cqeta1564/MotoLogger/README.md

# MotoLogger: Comprehensive Motorcycle Telemetry Ecosystem







An end-to-end, high-performance motorcycle telemetry and data acquisition system. Features a custom **ESP32-S3 hardware logger**, **100 Hz BNO085 IMU fusion** for vibration-resistant lean angle calculation, **500 kbps TWAI CAN bus capture**, and a companion **Flutter mobile app** with **Android Auto** and **Apple CarPlay** dashboard projection. 100% offline and serverless.

> **Project Documentation & AI Agent Context:**
> - In-depth technical specifications, hardware schematics, and protocol details: [`PROJECT.md`](./PROJECT.md)
> - AI pair-programming rules, code standards, and Antigravity guidelines: [`AGENTS.md`](./AGENTS.md)
> - Antigravity workspace configuration: [`GEMINI.md`](./GEMINI.md)

---

## Key Features

- **Vibration-Resistant IMU Fusion (100 Hz):** CEVA/Hillcrest BNO085 9-DoF coprocessor running the Game Rotation Vector (GRV) algorithm to deliver precise motorcycle lean angle and pitch, completely immune to high-frequency engine vibrations and alternator magnetic interference.
- **Smart Fuel-Tank Calibration:** Intuitive side-stand calibration utilizing the flat fuel tank filler cap and phone accelerometer, coupled with a physical yellow builder's spirit level UI and line-art motorcycle animations.
- **Permanent NVS Offset Storage:** Mounting tare offsets calibrated from the phone are stored in ESP32 flash memory (`Preferences`), ensuring zero calibration drift across power cycles.
- **500 kbps Automotive TWAI CAN Bus:** Real-time capture of engine RPM, speed, throttle position, coolant temperature, and gear directly from the motorcycle ECU.
- **Zero Parasitic Battery Drain (0 mA):** Hardware latch (`FORCE_ON`) automatically cuts all power 15 seconds after engine shutdown, completely protecting the motorcycle battery.
- **Companion Flutter App (Apple HIG):** Clean Apple Cupertino design language, live dynamic lean arc gauge, 1.5G friction circle, offline SQLite session storage, and MoTeC i2 CSV / GPX export.
- **Android Auto & CarPlay Projection:** Direct telemetry projection onto motorcycle TFT head units (Chigee AIO-5, Carpuride, Ottocast).

---

## System Architecture

```
                                    +-----------------------------+
                                    | Motorcycle 12V Battery / OBD |
                                    +--------------+--------------+
                                                   | Power & CAN
                                                   v
   +-----------------------------------------------------------------------------------------------+
   |                                  MotoLogger Hardware (ESP32-S3)                               |
   |                                                                                               |
   |   [CAN Transceiver]  <--->  TWAI 500 kbps Engine (Listen-Only + Active OBD-II PIDs)           |
   |   [BNO085 9-DoF IMU] <--->  100 Hz Game Rotation Vector (Lean Angle / Roll & Pitch Fusion)     |
   |   [Power Latch]      <--->  Automatic 12V Latch & 15s Auto-Shutdown (0 mA Quiescent Drain)    |
   |   [MicroSD Slot]     <--->  32 KB Buffered Lossless Blackbox Logging (LOG_XXXX.CSV)           |
   +-----------------------------------------------+-----------------------------------------------+
                                                   |
                                                   | 25 Hz Real-Time BLE Stream (29-byte packet)
                                                   | (Coexists with wireless CarPlay / Android Auto)
                                                   v
   +-----------------------------------------------------------------------------------------------+
   |                                MotoLogger Mobile App (Flutter)                                |
   |                                                                                               |
   |   - Real-time Smartphone GPS Fusion (Coordinates, Bearing, Altitude, Speed)                    |
   |   - 100% Offline Local SQLite Storage (Sessions & Track Records)                              |
   |   - Export to CSV (MoTeC i2 / RaceRender / TrackAddict) and GPX                               |
   |                                                                                               |
   |       +------------------------------------+    +------------------------------------+        |
   |       |          Phone Screen UI           |    |     Head Unit Display Projection   |        |
   |       |  - Dynamic Lean Gauge (-60°..+60°) |    |  - Android Auto (Motorcycle TFT)   |        |
   |       |  - 1.5G G-G Friction Circle        |    |  - Apple CarPlay                   |        |
   |       |  - RPM Tachometer & Shift Light    |    |  - Large Gear & Lean Readout       |        |
   |       |  - Smart Fuel-Tank Calibration UI  |    |  - Automatic Screen Lock on Ride   |        |
   |       +------------------------------------+    +------------------------------------+        |
   +-----------------------------------------------------------------------------------------------+
```

---

## Repository Structure

```
MotoLogger/
├── AGENTS.md                                # AI Agent rules, guidelines, and conventions
├── GEMINI.md                                # Antigravity project configuration & rules
├── PROJECT.md                               # Complete system architecture and technical specs
├── README.md                                # Repository overview and quickstart
├── docs/                                    # Design & project management documentation
│   ├── DESIGN.md                            # Interface specifications & Apple HIG guidelines
│   ├── lean-canvas-motologger.xlsx          # Project Lean Canvas business model
│   ├── Casovy_harmonogram_MotoLogger.xlsx   # Project timeline & milestone schedule
│   └── review/                              # Visual verification evidence & benchmarks
│
├── hardware/                                # Complete PCB manufacturing, assembly & 3D enclosure
│   ├── 3dprint/                             # 3D-printable enclosure (BASE.stl, LID.stl, print.3mf)
│   ├── gerbers/                             # Production Gerber ZIP archives (neutral silkscreen)
│   │   ├── MotoLogger_Clean_Gerber.zip      # Main board gerbers
│   │   └── MotoLogger_OBD2_Plug_Gerber.zip  # OBD-II sandwich board gerbers
│   ├── assembly/                            # SMT / PCBA manufacturing data
│   │   ├── MotoLogger_BOM.csv               # Bill of Materials with LCSC part numbers
│   │   ├── MotoLogger_BOM.xlsx              # Formatted Excel BOM
│   │   ├── MotoLogger_Part_Placements.zip   # Top and bottom SMT placement diagrams
│   │   └── Ordering_Specs_JLCPCB_PCBWay.md  # Detailed fabrication and assembly specs
│   └── schematics/                          # Circuit schematics and reference
│       ├── MotoLogger_Schematic.png         # Circuit schematic diagram
│       ├── MotoLogger_Schematic.json        # Schematic source
│       └── MotoLogger_Pinout_Reference.h    # Header pad mapping reference
│
├── firmware/                                # Modular C++ ESP32-S3 Firmware (PlatformIO)
│   ├── platformio.ini                       # PlatformIO build configuration
│   ├── include/                             # Header definitions (config.h, types.h, ring_buffer.h)
│   └── src/                                 # Subsystem implementations (CAN, IMU, BLE, Power, Storage, LED)
│
└── app/                                     # Companion Mobile App (Flutter)
    ├── pubspec.yaml                         # Flutter dependencies
    ├── lib/                                 # Dart source code (Clean Layered Architecture)
    ├── android/                             # Android configuration + Android Auto Service
    ├── integration_test/                    # End-to-end integration tests
    └── test/                                # Automated unit & widget test suite (61+ tests)
```

---

## Hardware Specifications & Pinout

| Periphery / Function | ESP32-S3 Pin | Signal Description |
| :--- | :--- | :--- |
| **CAN TX** | `GPIO14` | SN65HVD230 Transceiver TX |
| **CAN RX** | `GPIO13` | SN65HVD230 Transceiver RX |
| **CAN RS** | `GPIO38` | Transceiver Mode (LOW = Active 500k/250k/1M, HIGH = Standby) |
| **IMU MISO** | `GPIO1` | BNO085 HSPI MISO (GY-BNO08X `SDA/MISO/TX`) |
| **IMU SCK** | `GPIO2` | BNO085 HSPI Clock (3 MHz) (GY-BNO08X `SCL/SCK/RX`) |
| **IMU MOSI** | `GPIO4` | BNO085 HSPI MOSI (GY-BNO08X `ADDR/MOSI`, or pad `GPIO6` on custom PCB) |
| **IMU CS** | `GPIO5` | BNO085 HSPI Chip Select (GY-BNO08X `CS`, or pad `GPIO47` on custom PCB) |
| **IMU INT (H_INTN)**| `GPIO12` | BNO085 SHTP Interrupt / Data-Ready (Active LOW) |
| **IMU RST** | `GPIO48` | BNO085 Hardware Reset (Active LOW) |
| **3V3 Switch Rail** | `GPIO21` | Switched 3.3V power rail (MT9700 load switch) |
| **MicroSD CS** | `GPIO45` | SPI Chip Select (Dedicated FSPI bus) |
| **MicroSD SCK** | `GPIO39` | SPI Clock (25 MHz) |
| **MicroSD MOSI** | `GPIO40` | SPI Master Out Slave In |
| **MicroSD MISO** | `GPIO41` | SPI Master In Slave Out |
| **Power Latch** | `GPIO17` | `FORCE_ON` - Keep HIGH to maintain power from 12V |
| **Digital Battery Sense**| `GPIO8` | `SENSE_V_DIG` - HIGH when alternator is charging |
| **Analog Battery Sense** | `GPIO9` | `SENSE_V_ANA` - ADC with 1:11 resistor divider |
| **Blue LED** | `GPIO10` | IMU / MicroSD status / Auto-shutdown countdown |
| **Yellow LED** | `GPIO11` | Power rail status / CAN frame burst flash |

---

## Quick Start Guide

### 1. Firmware Build & Upload (PlatformIO)
```bash
# Navigate to firmware directory
cd firmware

# Build firmware
pio run

# Flash to connected ESP32-S3 over USB-C
pio run --target upload

# Open Serial Monitor (115200 baud)
pio device monitor
```

### 2. Mobile App Run (Flutter)
```bash
# Navigate to mobile app directory
cd app

# Fetch packages
flutter pub get

# Run unit tests
flutter test

# Run on connected phone or emulator
flutter run
```

### 3. Android Auto Head Unit Setup
1. In phone **Settings > Android Auto**, tap **Version** 10 times to enable **Developer Mode**.
2. Open top-right menu > **Developer settings**, enable **Unknown sources**.
3. Connect phone to your motorcycle display (e.g. Chigee AIO-5, Carpuride, Ottocast) and open MotoLogger.

---

## License
Open-source under MIT License.
