cqeta1564/MotoLogger/docs/review/after-320x568.png

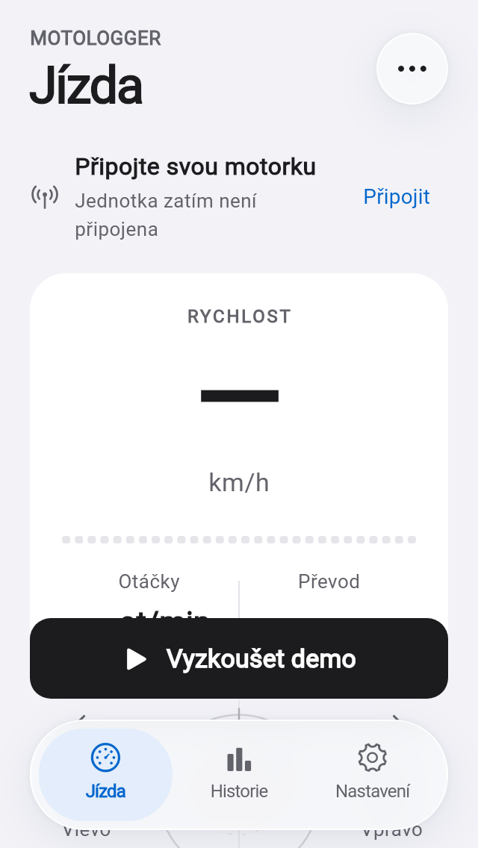
docs/review/after-320x568.png
