cqeta1564/MotoLogger/docs/review/after-430x932.png

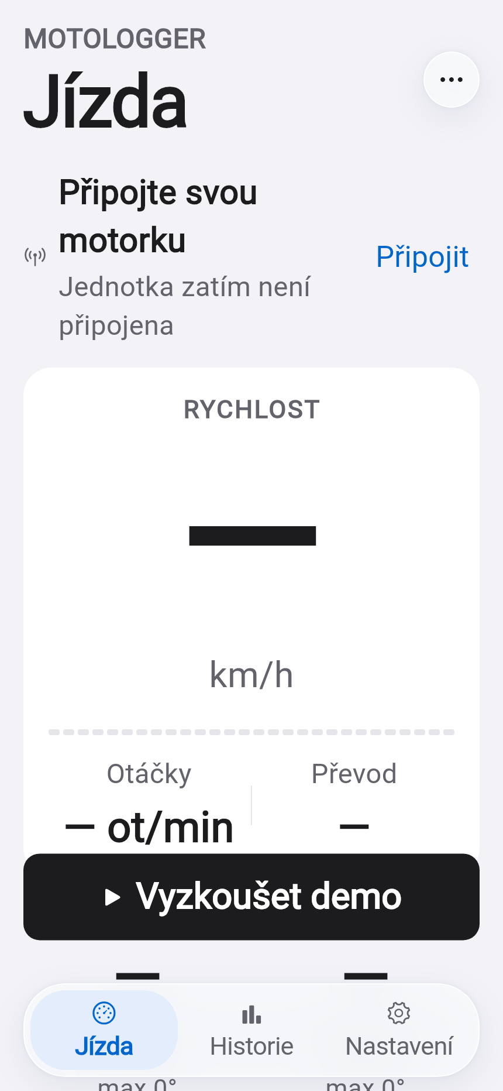
docs/review/after-430x932.png
