cqeta1564/MotoLogger/docs/review/after-844x390.png

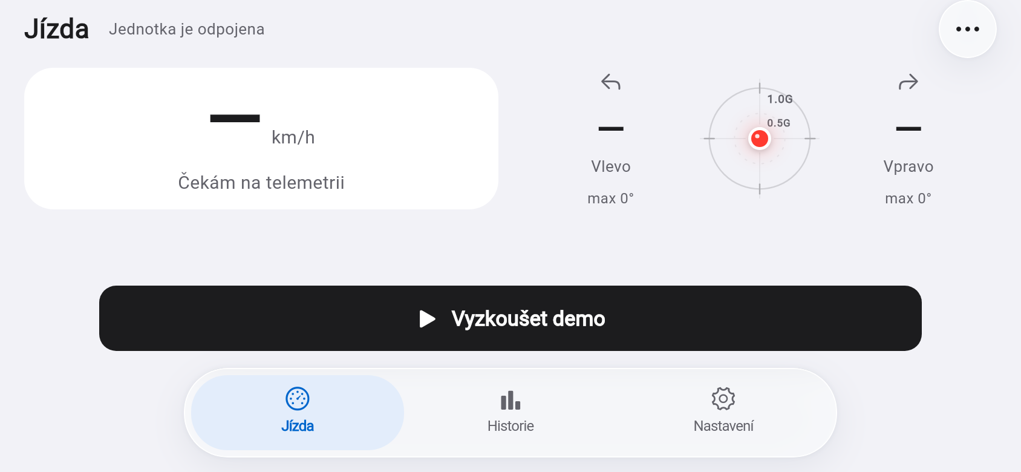
docs/review/after-844x390.png
