cqeta1564/MotoLogger/docs/review/after-detail.png

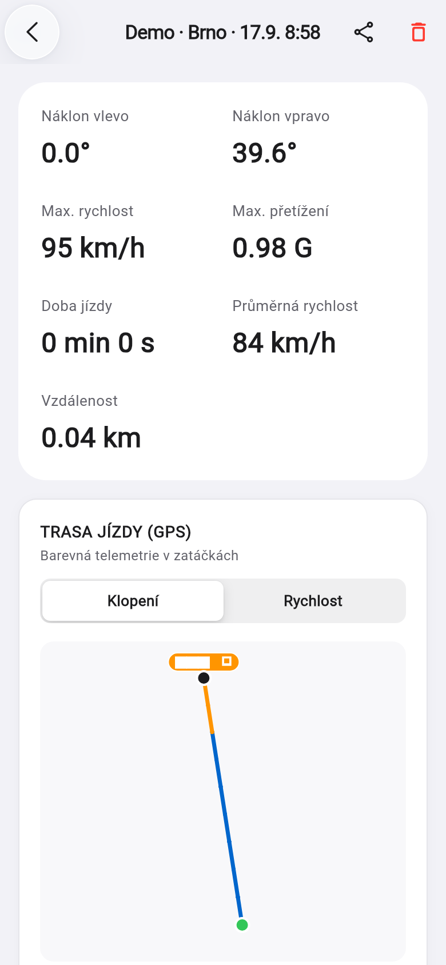
docs/review/after-detail.png
