cqeta1564/MotoLogger/docs/review/after-profile-keyboard-large-text.png

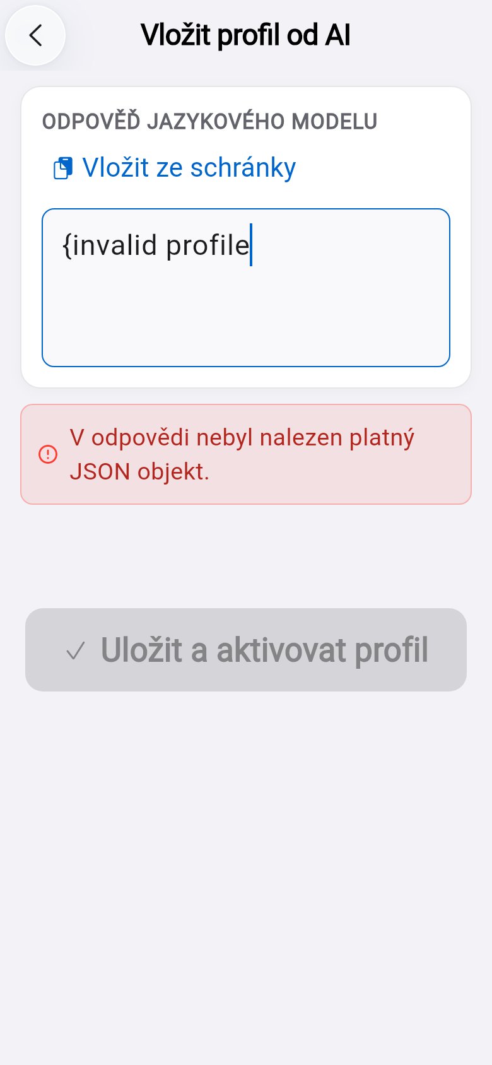
docs/review/after-profile-keyboard-large-text.png
