cqeta1564/MotoLogger/docs/review/after-ride-disconnected.png

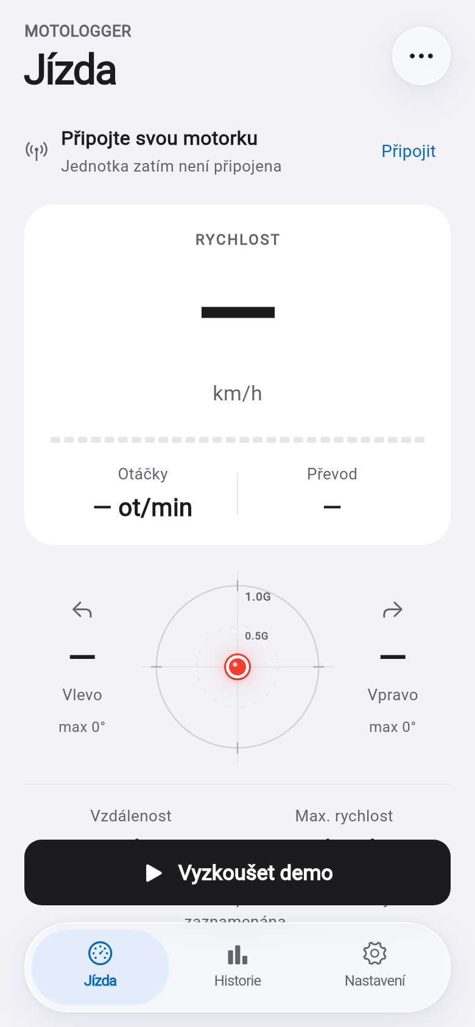
docs/review/after-ride-disconnected.png
