cqeta1564/MotoLogger/docs/review/after-ride-recording.png

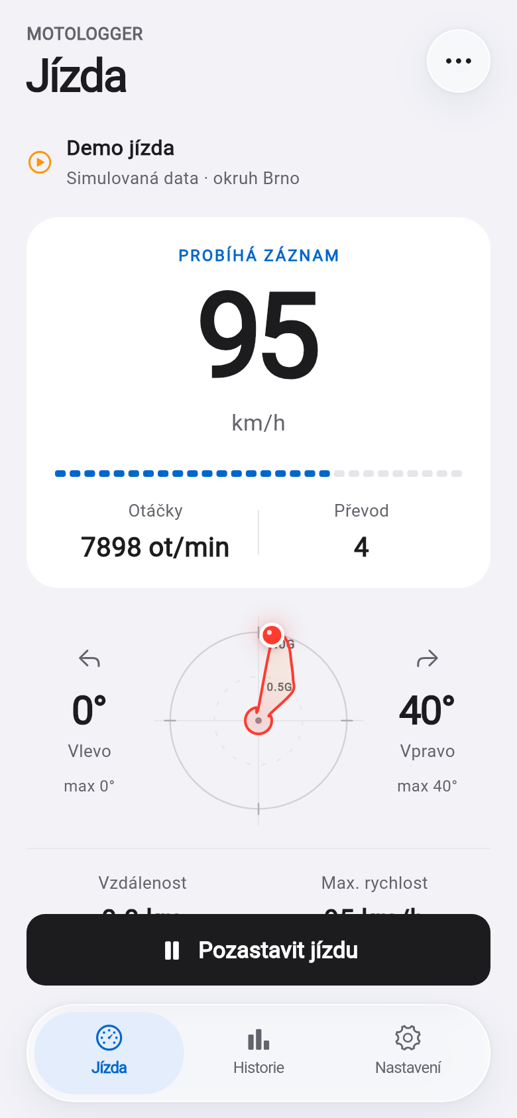
docs/review/after-ride-recording.png
