cqeta1564/MotoLogger/docs/review/after-settings.png

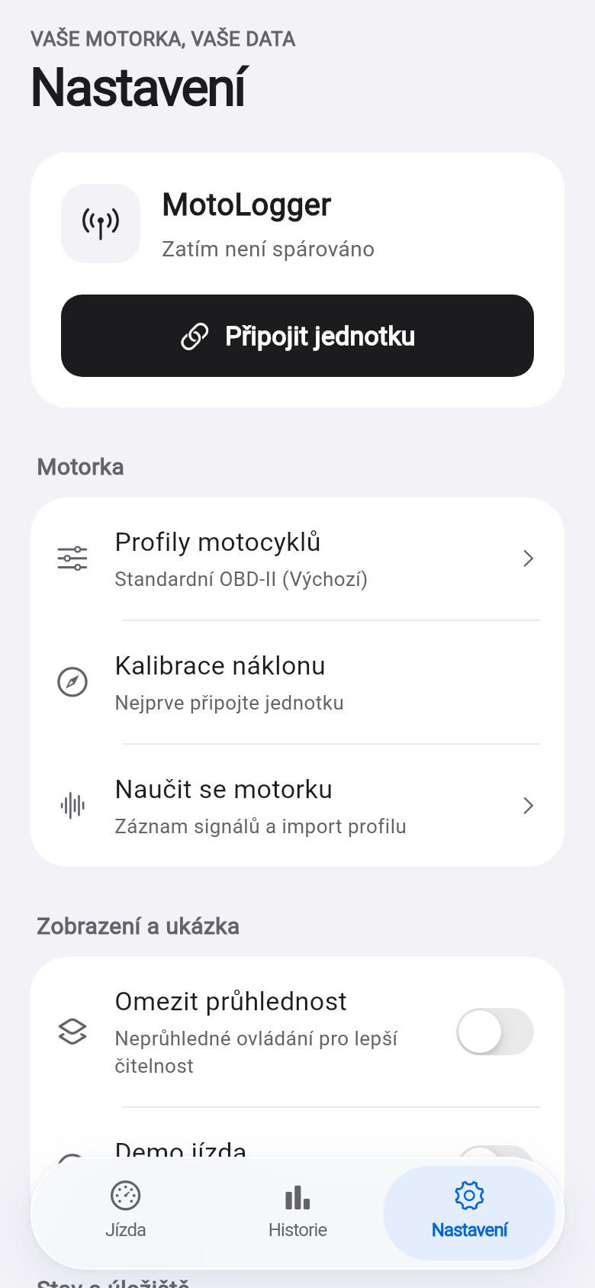
docs/review/after-settings.png
