cqeta1564/MotoLogger/docs/review/android-detail.png

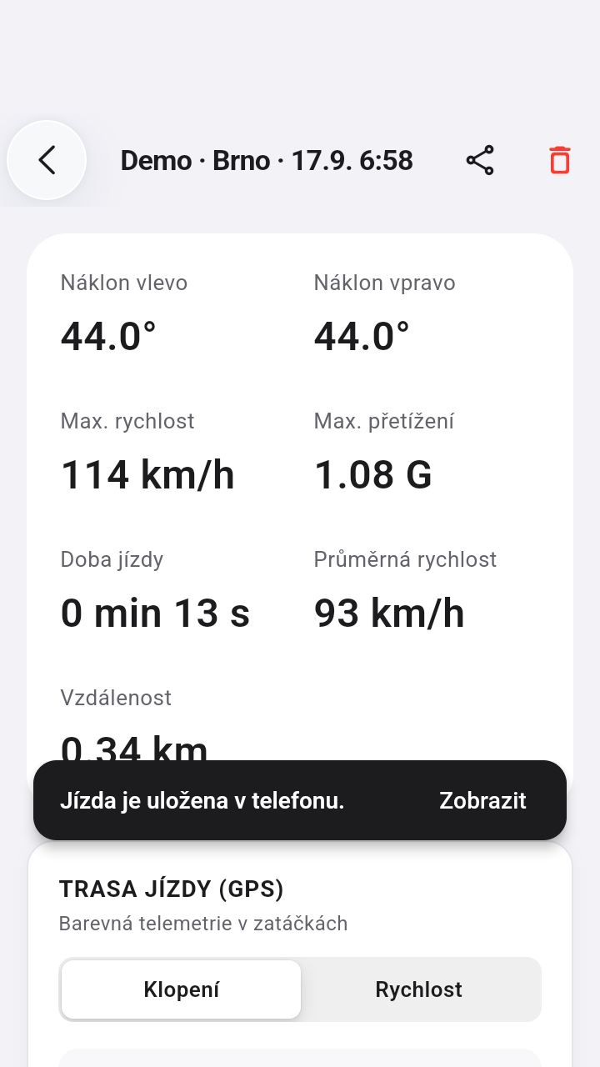
docs/review/android-detail.png
