cqeta1564/MotoLogger/docs/review/android-motion-release-launch.png

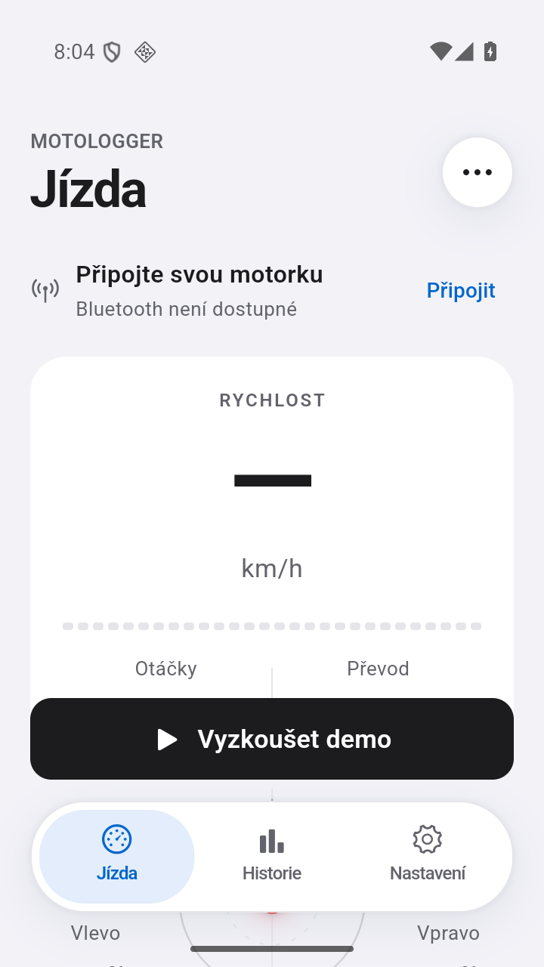
docs/review/android-motion-release-launch.png
