cqeta1564/MotoLogger/docs/review/android-motion-ride-paused.png

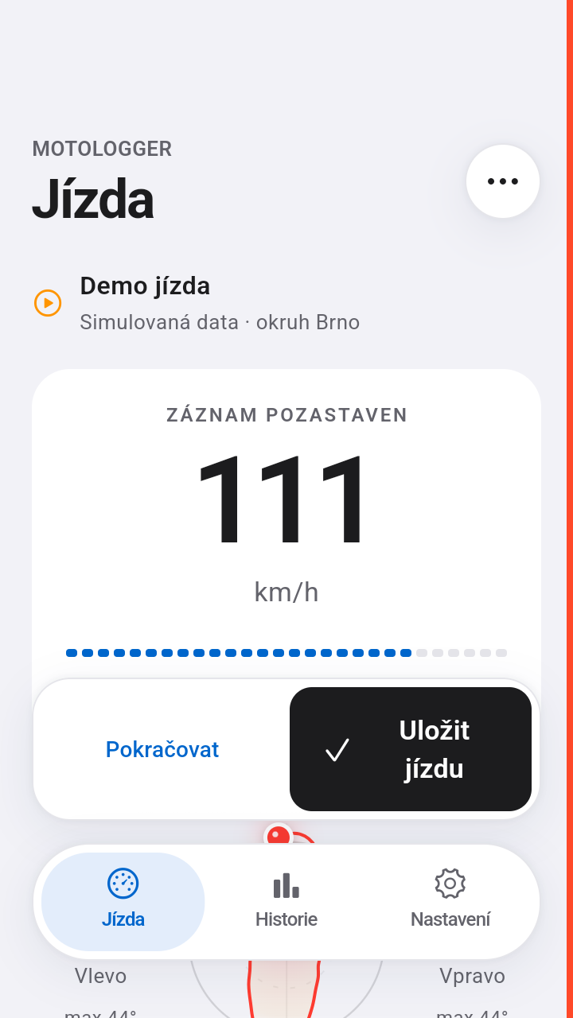
docs/review/android-motion-ride-paused.png
