cqeta1564/MotoLogger/docs/review/android-motion-ride-recording.png

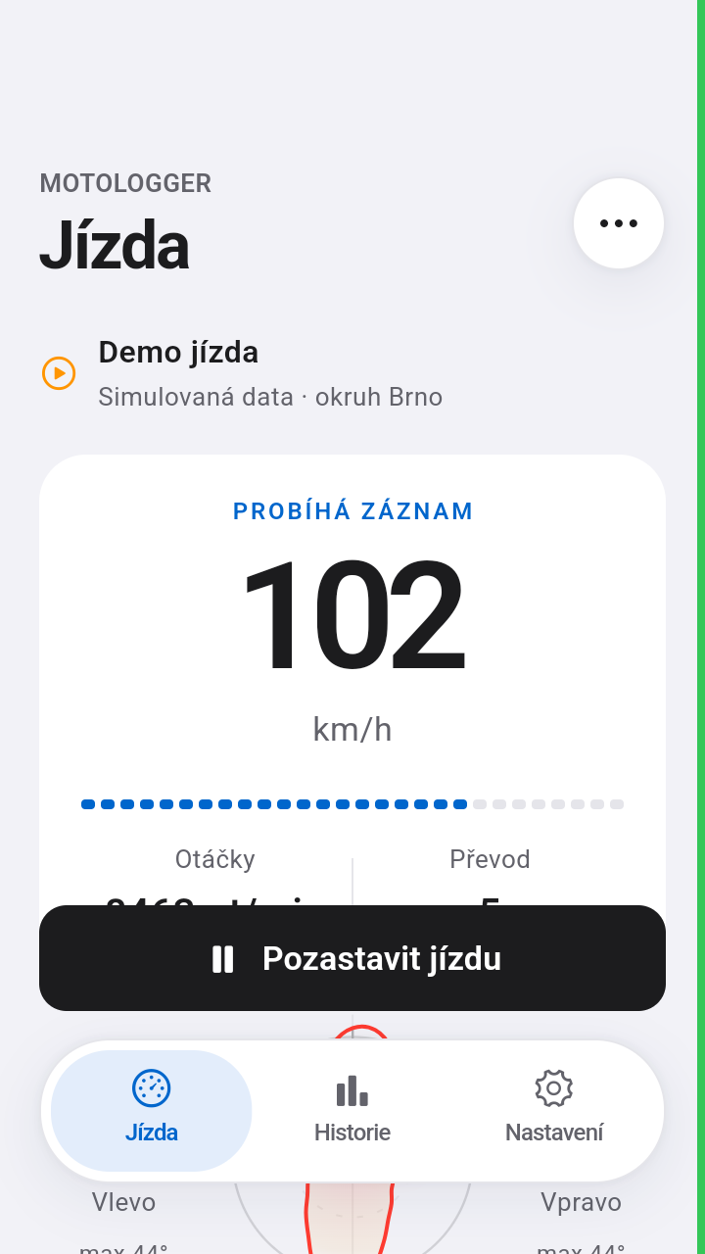
docs/review/android-motion-ride-recording.png
