cqeta1564/MotoLogger/docs/review/android-opaque.png

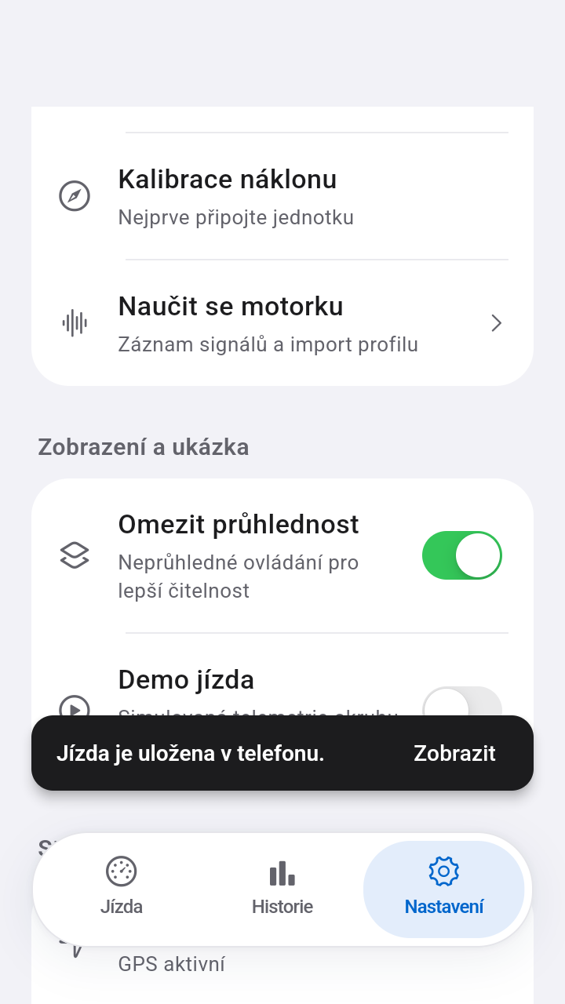
docs/review/android-opaque.png
