cqeta1564/MotoLogger/docs/review/android-relaunch-saved-ride.png

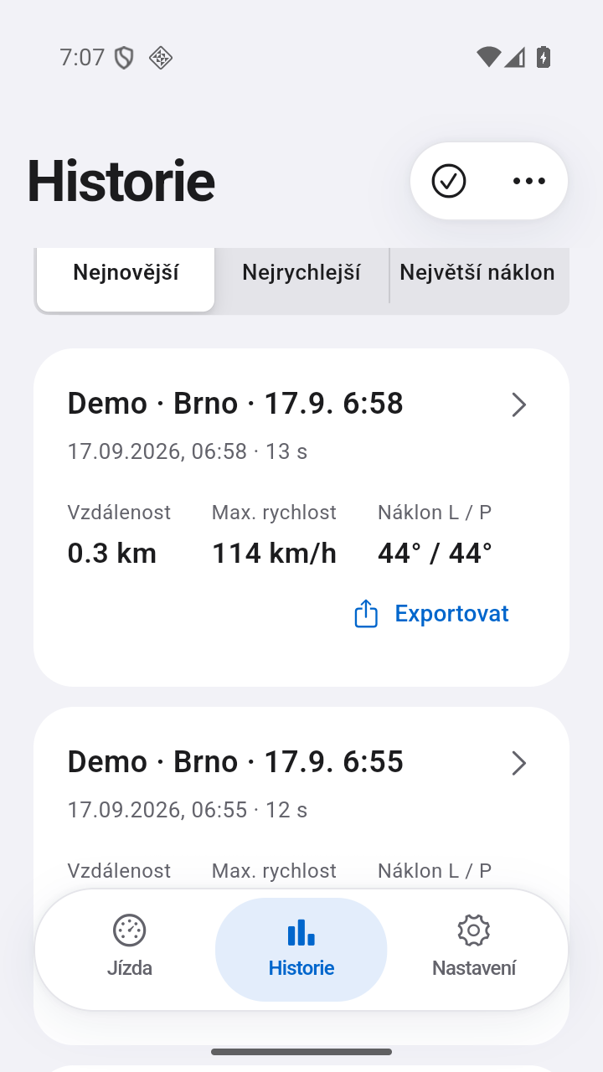
docs/review/android-relaunch-saved-ride.png
