cqeta1564/MotoLogger/docs/review/android-ride-disconnected.png

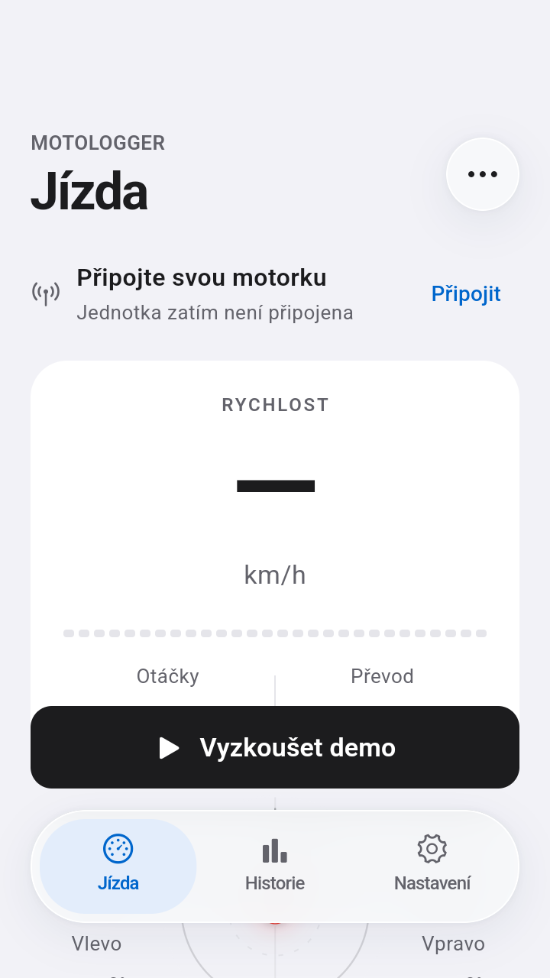
docs/review/android-ride-disconnected.png
