cqeta1564/MotoLogger/docs/review/android-settings.png

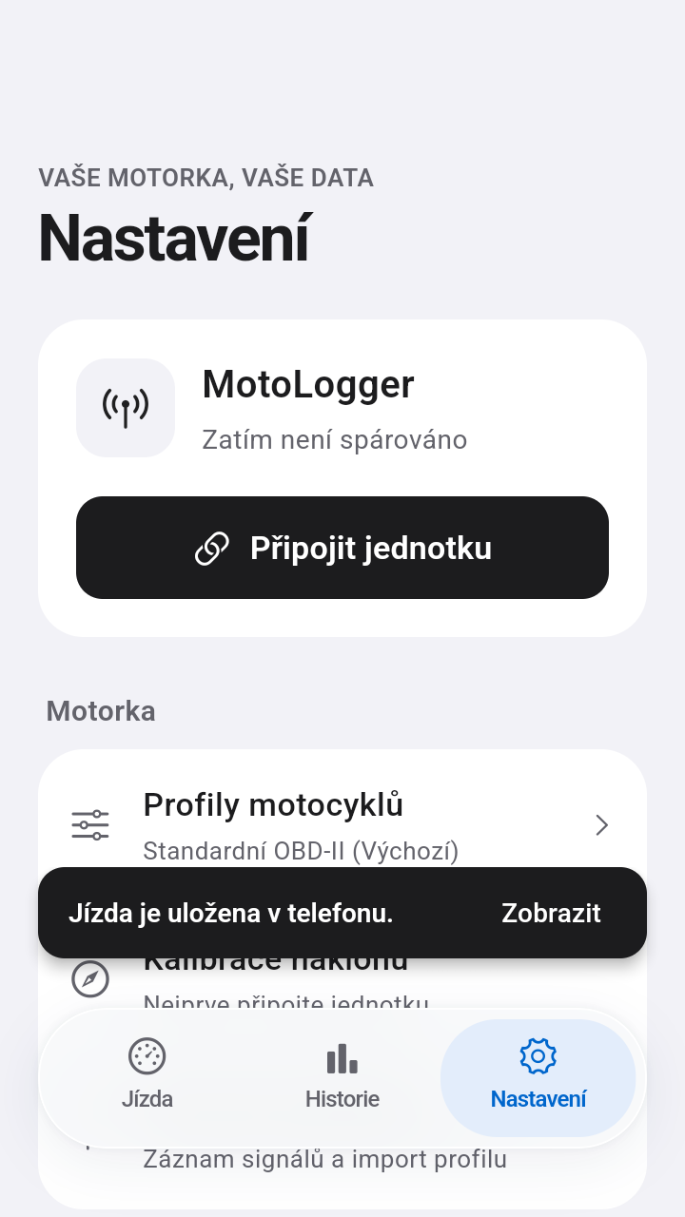
docs/review/android-settings.png
