cqeta1564/MotoLogger/docs/review/before-ride.png

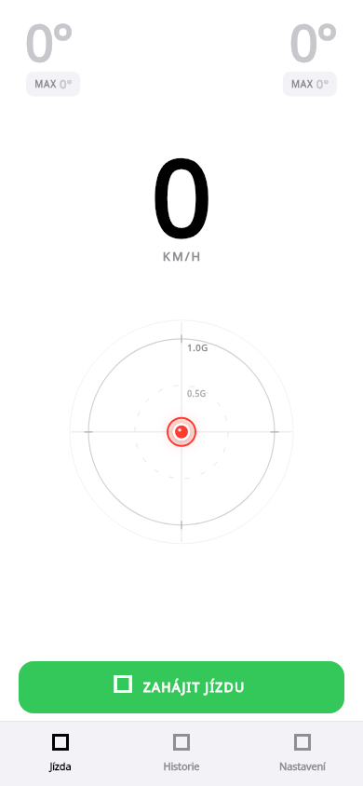
docs/review/before-ride.png
