cqeta1564/MotoLogger/docs/review/before-settings.png

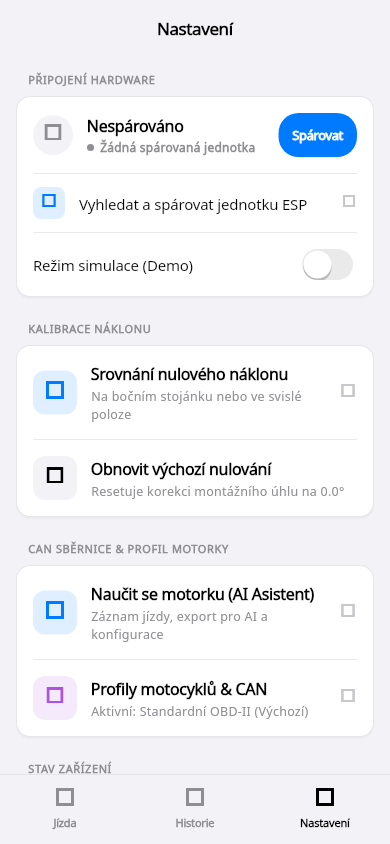
docs/review/before-settings.png
