cqeta1564/MotoLogger/docs/review/ios-sim-launch.png

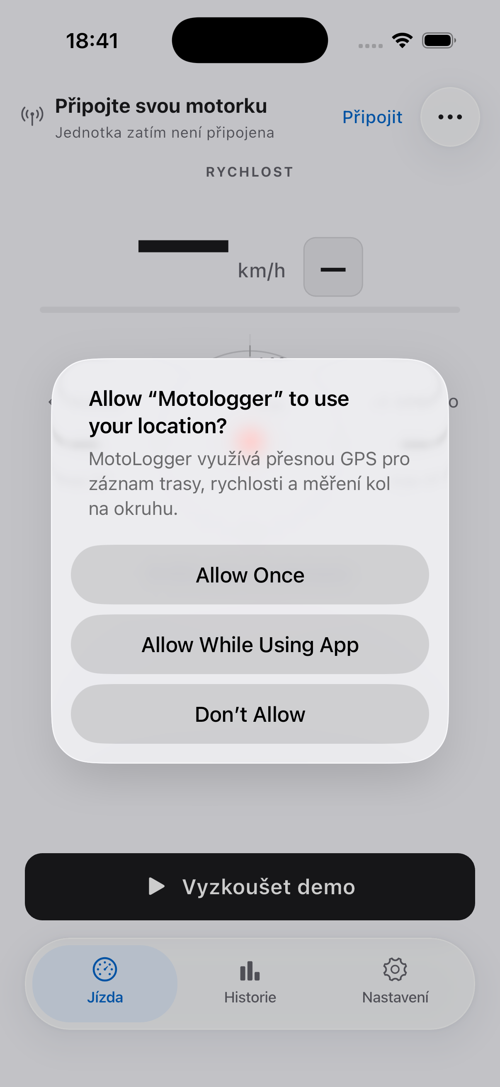
docs/review/ios-sim-launch.png
