cqeta1564/MotoLogger/docs/review/lean-left-green.png

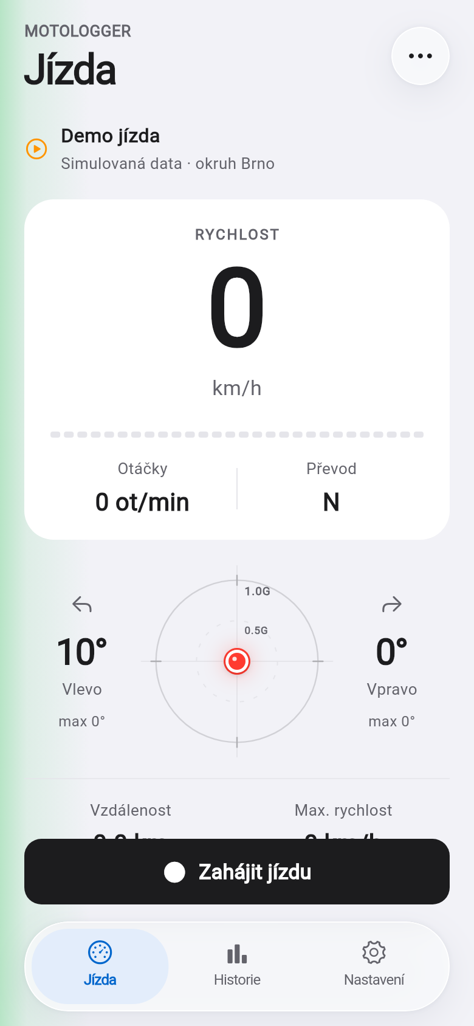
docs/review/lean-left-green.png
