cqeta1564/MotoLogger/docs/review/lean-left-orange.png

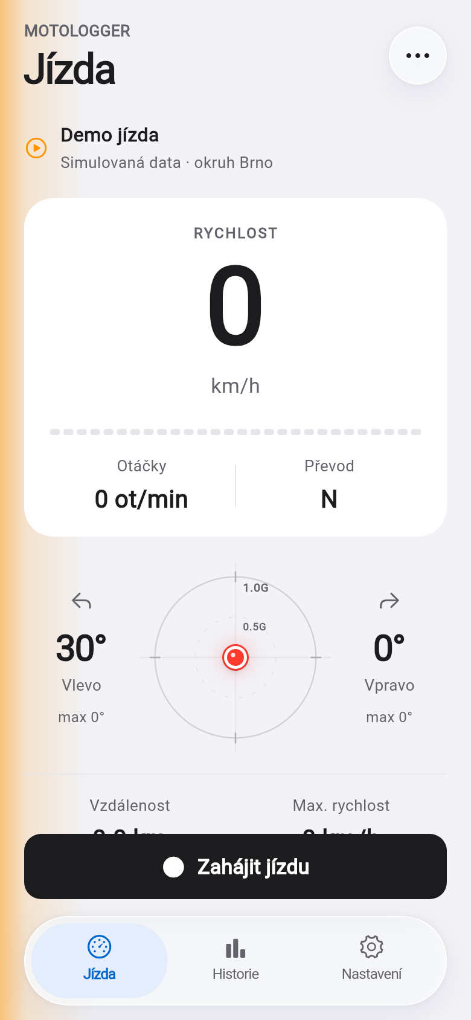
docs/review/lean-left-orange.png
