cqeta1564/MotoLogger/docs/review/lean-right-red.png

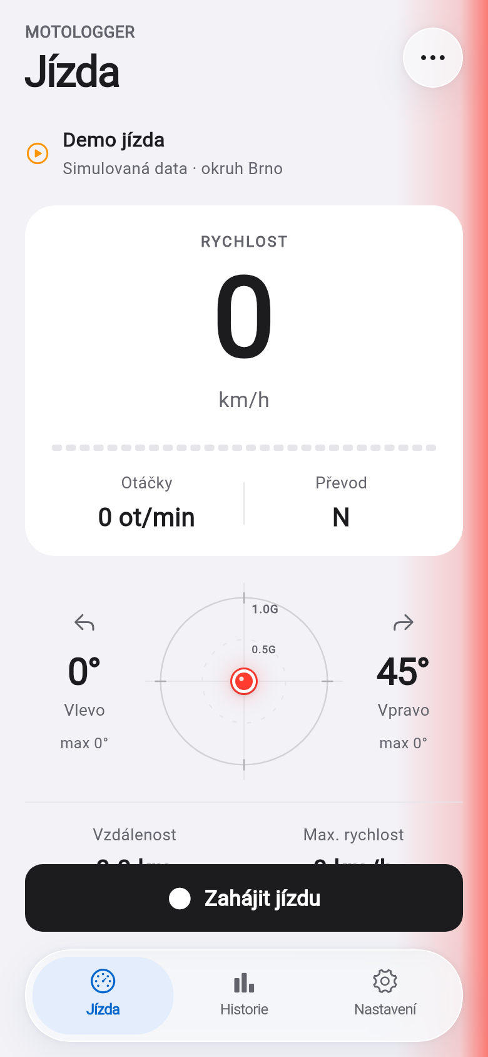
docs/review/lean-right-red.png
