cqeta1564/MotoLogger/docs/review/tab-slide-midpoint.png

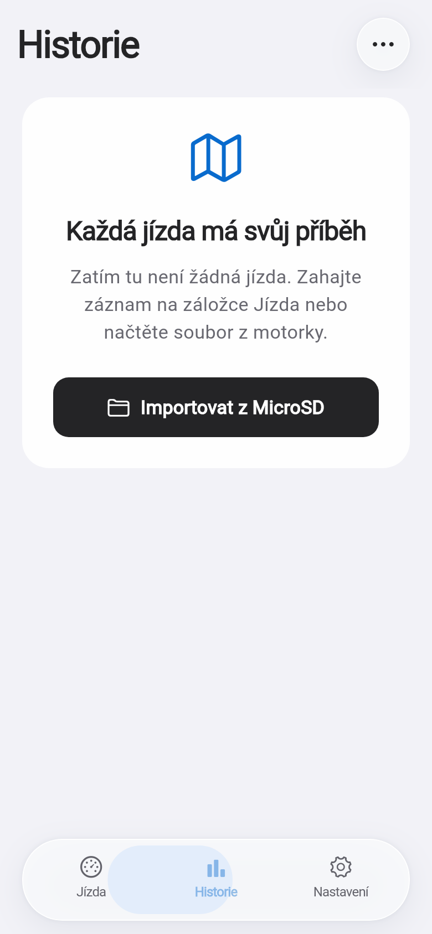
docs/review/tab-slide-midpoint.png
