cqeta1564/MotoLogger/hardware/schematics/MotoLogger_Schematic.png

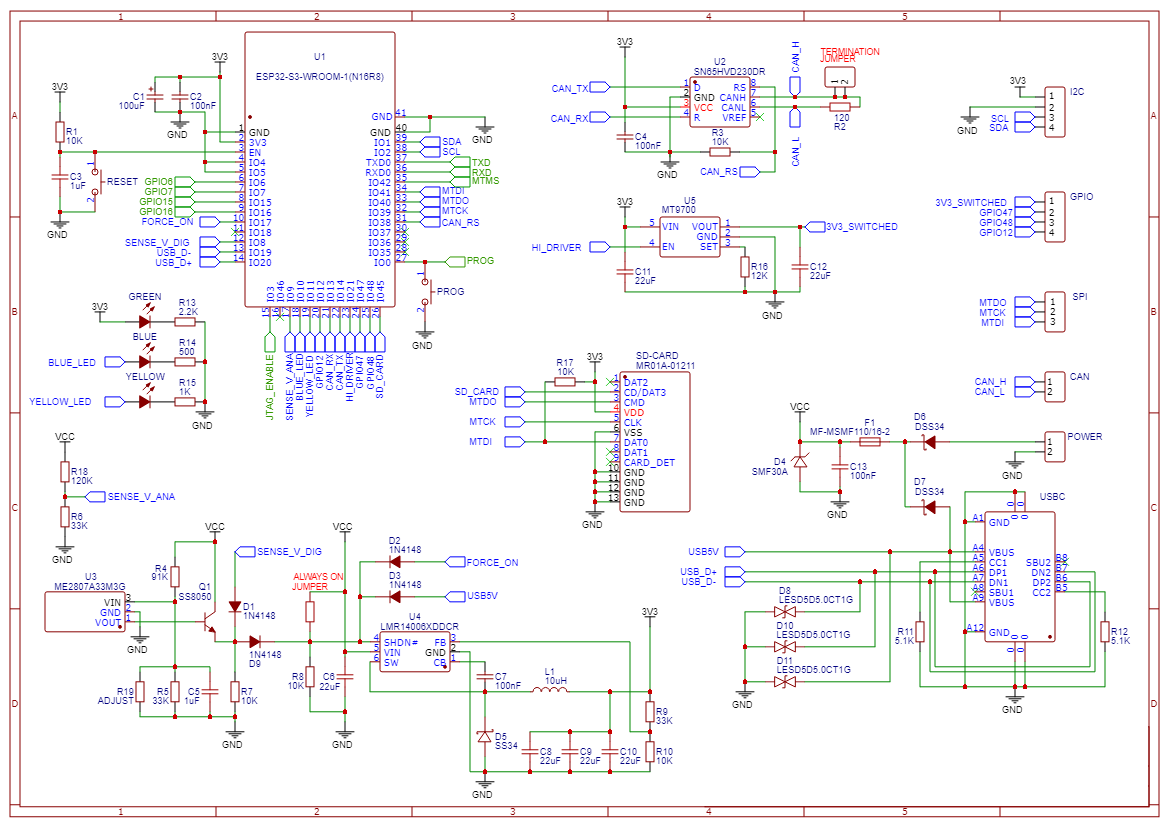
hardware/schematics/MotoLogger_Schematic.png
