cqeta1564/MotoLogger/hardware/3dprint/BASE.stl

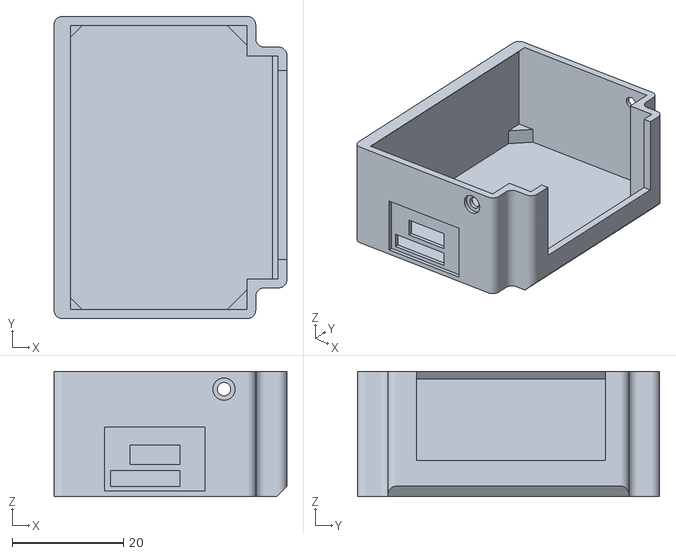
[picture p25: CAD file, 2026-10-16]
hardware/3dprint/BASE.stl
41.8 x 54.2 x 22.5
