cqeta1564/MotoLogger/hardware/3dprint/LID.stl

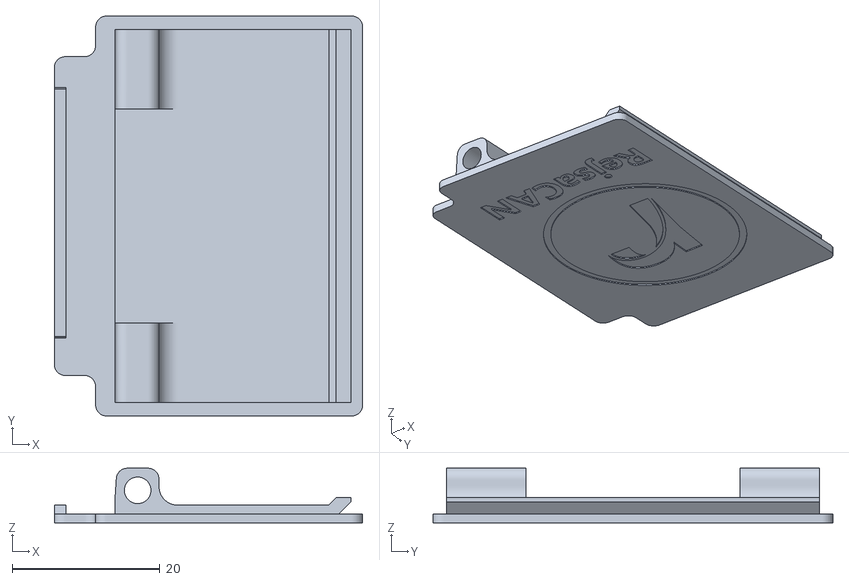
[picture p26: CAD file, 2026-10-16]
hardware/3dprint/LID.stl
41.8 x 54.2 x 7.40
