cqeta1564/MotoLogger/hardware/3dprint/print.3mf

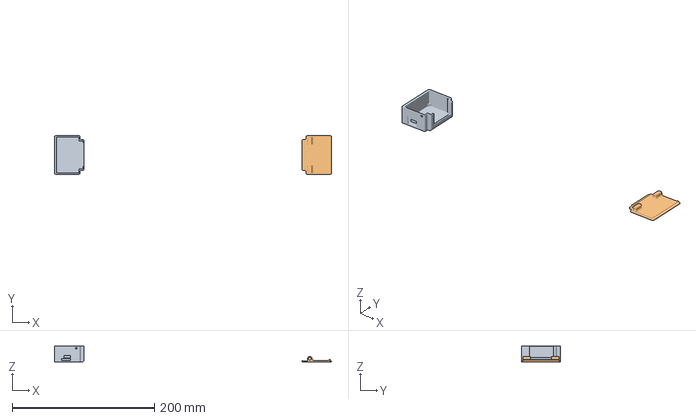
[picture p27: CAD file, 2026-10-16]
hardware/3dprint/print.3mf
389.7 x 54.2 x 22.5 mm
BASE.stl
LID.stl
