cqeta1564/MotoLogger/docs/review/after-history.png

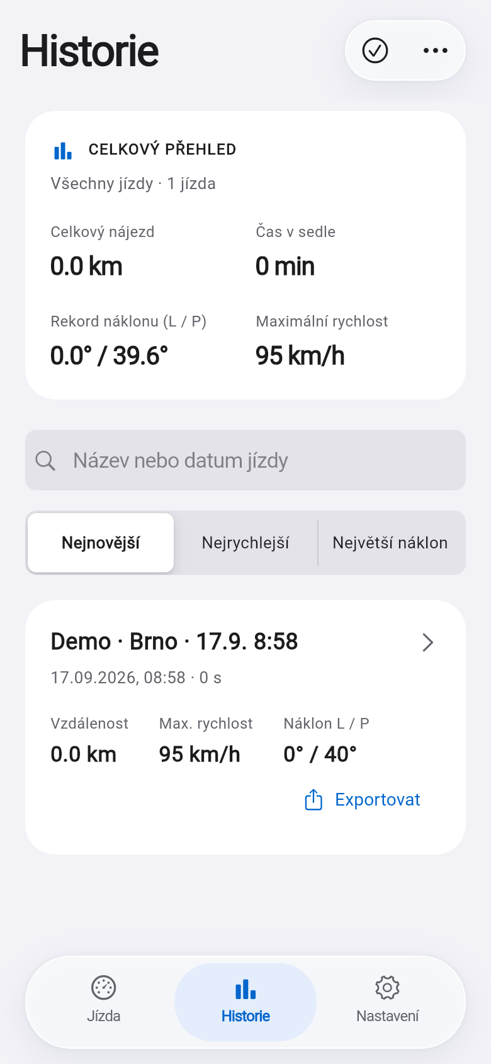
docs/review/after-history.png
