cqeta1564/MotoLogger/docs/review/android-history.png

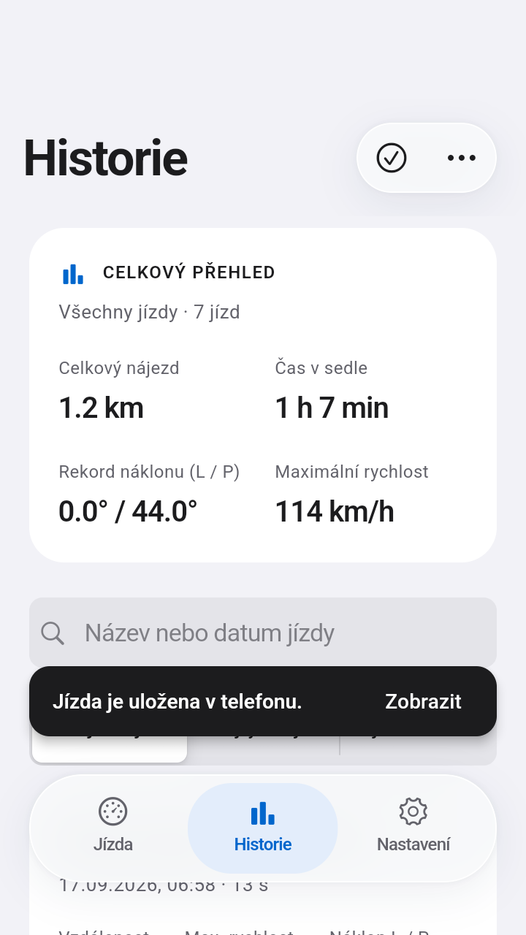
docs/review/android-history.png
