cqeta1564/MotoLogger/docs/review/android-relaunch-history.png

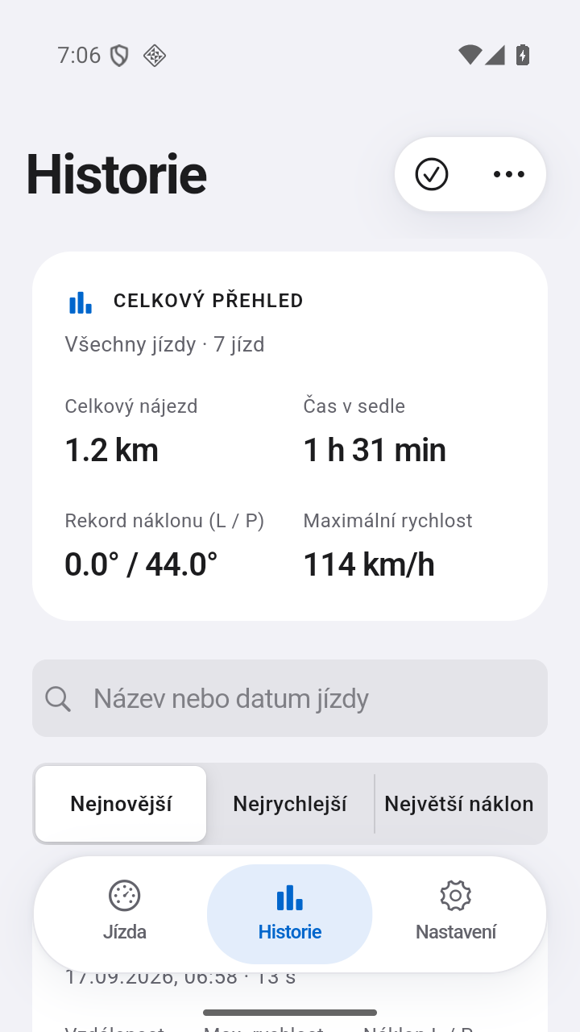
docs/review/android-relaunch-history.png
