cqeta1564/MotoLogger/docs/review/before-history.png

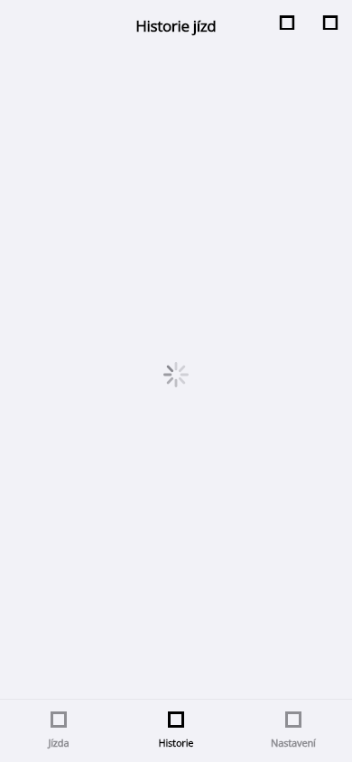
docs/review/before-history.png
