cqeta1564/MotoLogger/(commit log)

2026-09-07 Initial commit: Complete MotoLogger ecosystem (Hardware, Firmware, Mobile App)
    [MotoLogger_v3.4_BOM.csv, MotoLogger_v3.4_BOM.xlsx]
2026-09-07 Remove all v3.4 version mentions and rename hardware assets to clean MotoLogger branding
    [MotoLogger_BOM.csv, MotoLogger_BOM.xlsx]
2026-09-08 Implement dynamic corner gradient wash reacting to motorcycle lean angle
2026-09-09 feat(calibration): add smart side-stand tank calibration with vector illustration and Apple spirit level
2026-09-09 feat(calibration): add line-art phone placement animation, humorous construction spirit level, and clean unified Apple-style UX
2026-09-09 style(calibration): convert calibration screen and widgets to Apple light theme, remove AI look and text
2026-09-09 Refactor calibration UI to minimalist monochrome Apple style with spirit level focal point
2026-09-09 Unify primary confirmation and action button heights and border radii across entire app
2026-09-09 Pin calibration action buttons to bottom matching exact vertical screen position of dashboard buttons
2026-09-10 Unify calibration UI with bike upright animation and add reset confirmation dialog
2026-09-10 Rework fuel tank calibration animation with complete motorcycle silhouette on side stand
2026-09-10 refactor: remove unused dead widgets (apple_spirit_level, motorcycle_tank_illustration)
2026-09-10 feat: unify mounting roll offset calibration logic across stand and upright modes
2026-09-10 feat(firmware): add NVS persistence and command 0x02 for tare mounting offset
2026-09-10 feat(can): add motorcycle learning flow and AI CAN profile mapping
2026-09-10 feat(ble): add ESP32 device pairing and scanner screen
2026-09-10 feat(analytics): add GPX export, GPS track map canvas, and post-ride G-G diagram
2026-09-10 fix(ui): prevent renderflex overflow in gps track map header and legend
2026-09-11 feat(telemetry): add high-precision Brno Circuit GPS simulation to demo mode
2026-09-17 feat(app): polish glass UI and restore animated lean feedback
    Preserve Flutter navigation and telemetry workflows, add accessible motion and material preferences, and harden ride persistence and error handling.
    Add widget and Android integration coverage, design documentation, and rendered review evidence for version 1.0.1.
2026-10-16 feat(firmware): harden dual-core telemetry, NVS tare, and power supervisor
2026-10-16 feat(hardware): add 3D-printable PETG/ASA enclosure models and specs
2026-10-16 fix(app): harden BLE lifecycle, calibration math, CSV round-trip, and HUD telemetry
2026-10-16 feat(telemetry): implement ble sd log sync, circuit lap timer, and hardware diagnostics
2026-10-18 feat(firmware): switch BNO085 IMU interface from I2C to dedicated 3 MHz HSPI
2026-10-18 fix(firmware): prevent 500ms SPI HAL blocking when draining BNO085 reports
2026-10-19 feat(system): add live CAN sniffer, configurable baudrate, live lap timer, and Android Auto projection
2026-10-19 fix(system): resolve live lap timestamp domain, TWAI live baudrate switch, and car projection lifecycle
2026-10-19 feat(system): add background recording service, iOS target, and wireless OTA maintenance
2026-10-19 fix(system): harden OTA power latch, task stack sizes, and Android 14 FGS safety
2026-10-22 chore(ios): configure Apple development team for physical device deployment
2026-10-22 feat(ui): implement apple spring physics, tabular figures, and taptic engine haptics
2026-10-22 feat(ui): refine apple spring tab bar, specular glass edge, and calm dashboard layout
2026-10-22 feat(ui): implement apple health inset grouped layout, apple music miniplayer dock, and tactile scale button
