cqeta1564/MotoLogger/(notices)

Notices in the files:
README.md:
License: MIT
